arsalan0004/word-watch/V2/schematic and board/watchV2.brd

## EAGLE design V2/schematic and board/watchV2.brd (2021-01-21)

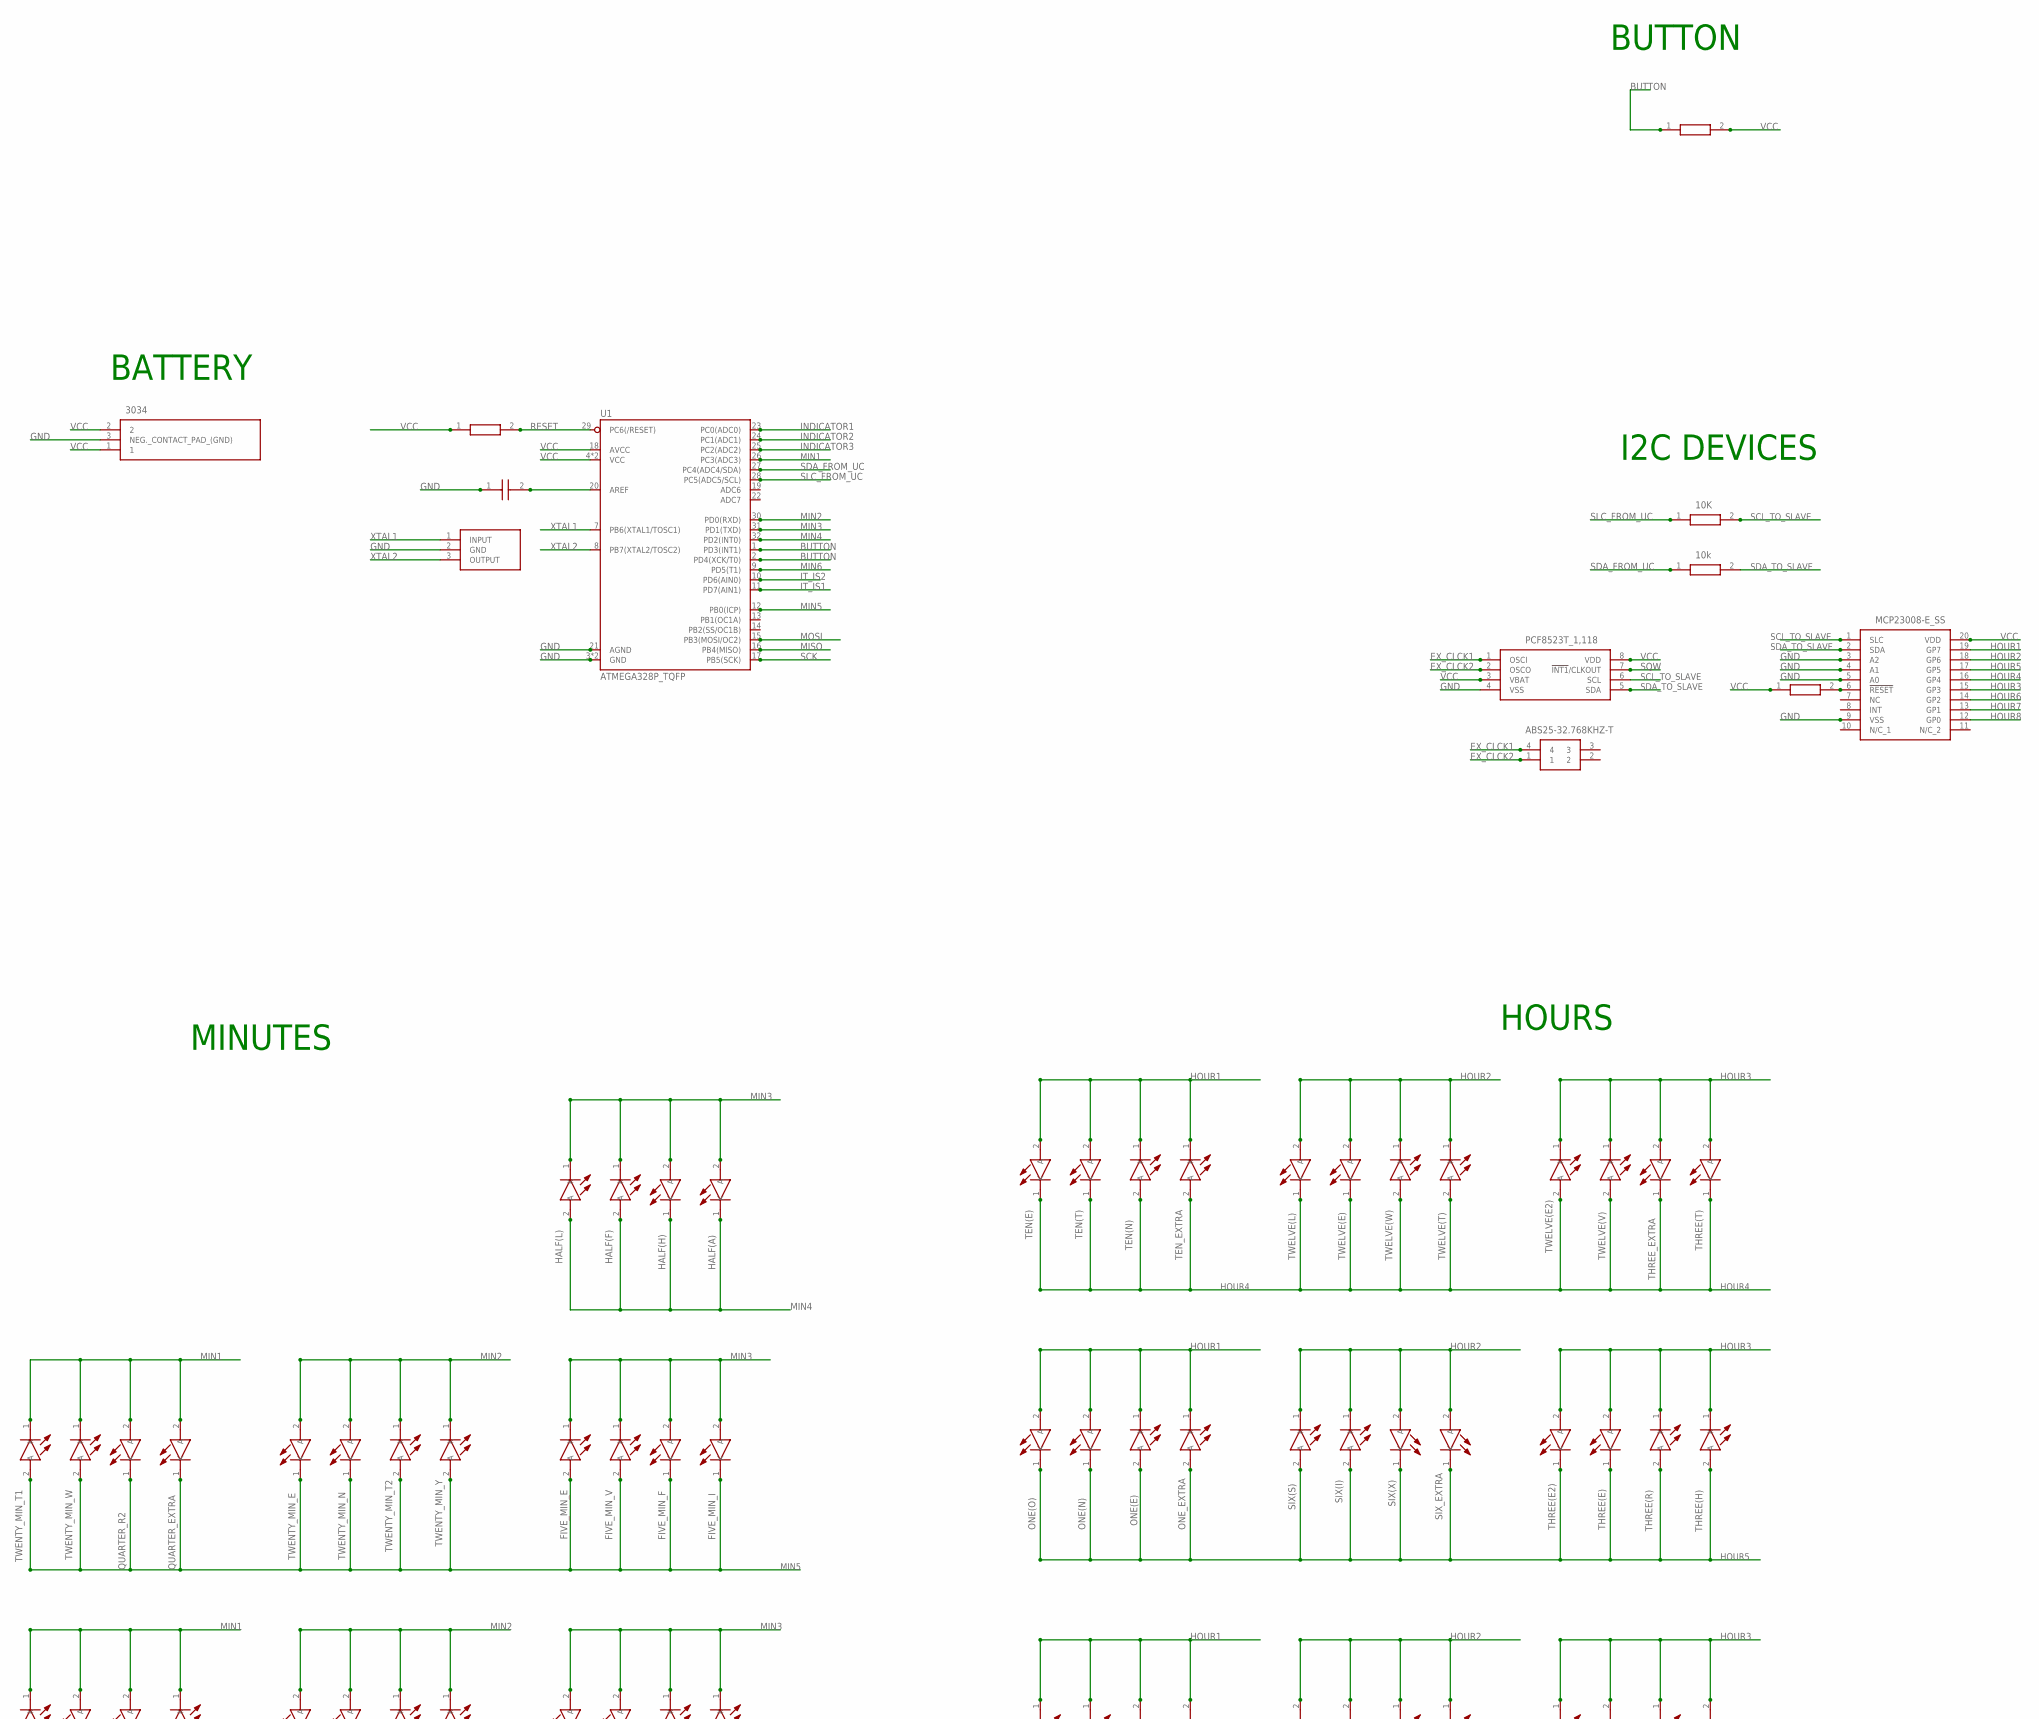
[picture p1: schematic watchV2.sch, part in row 1, column 1]

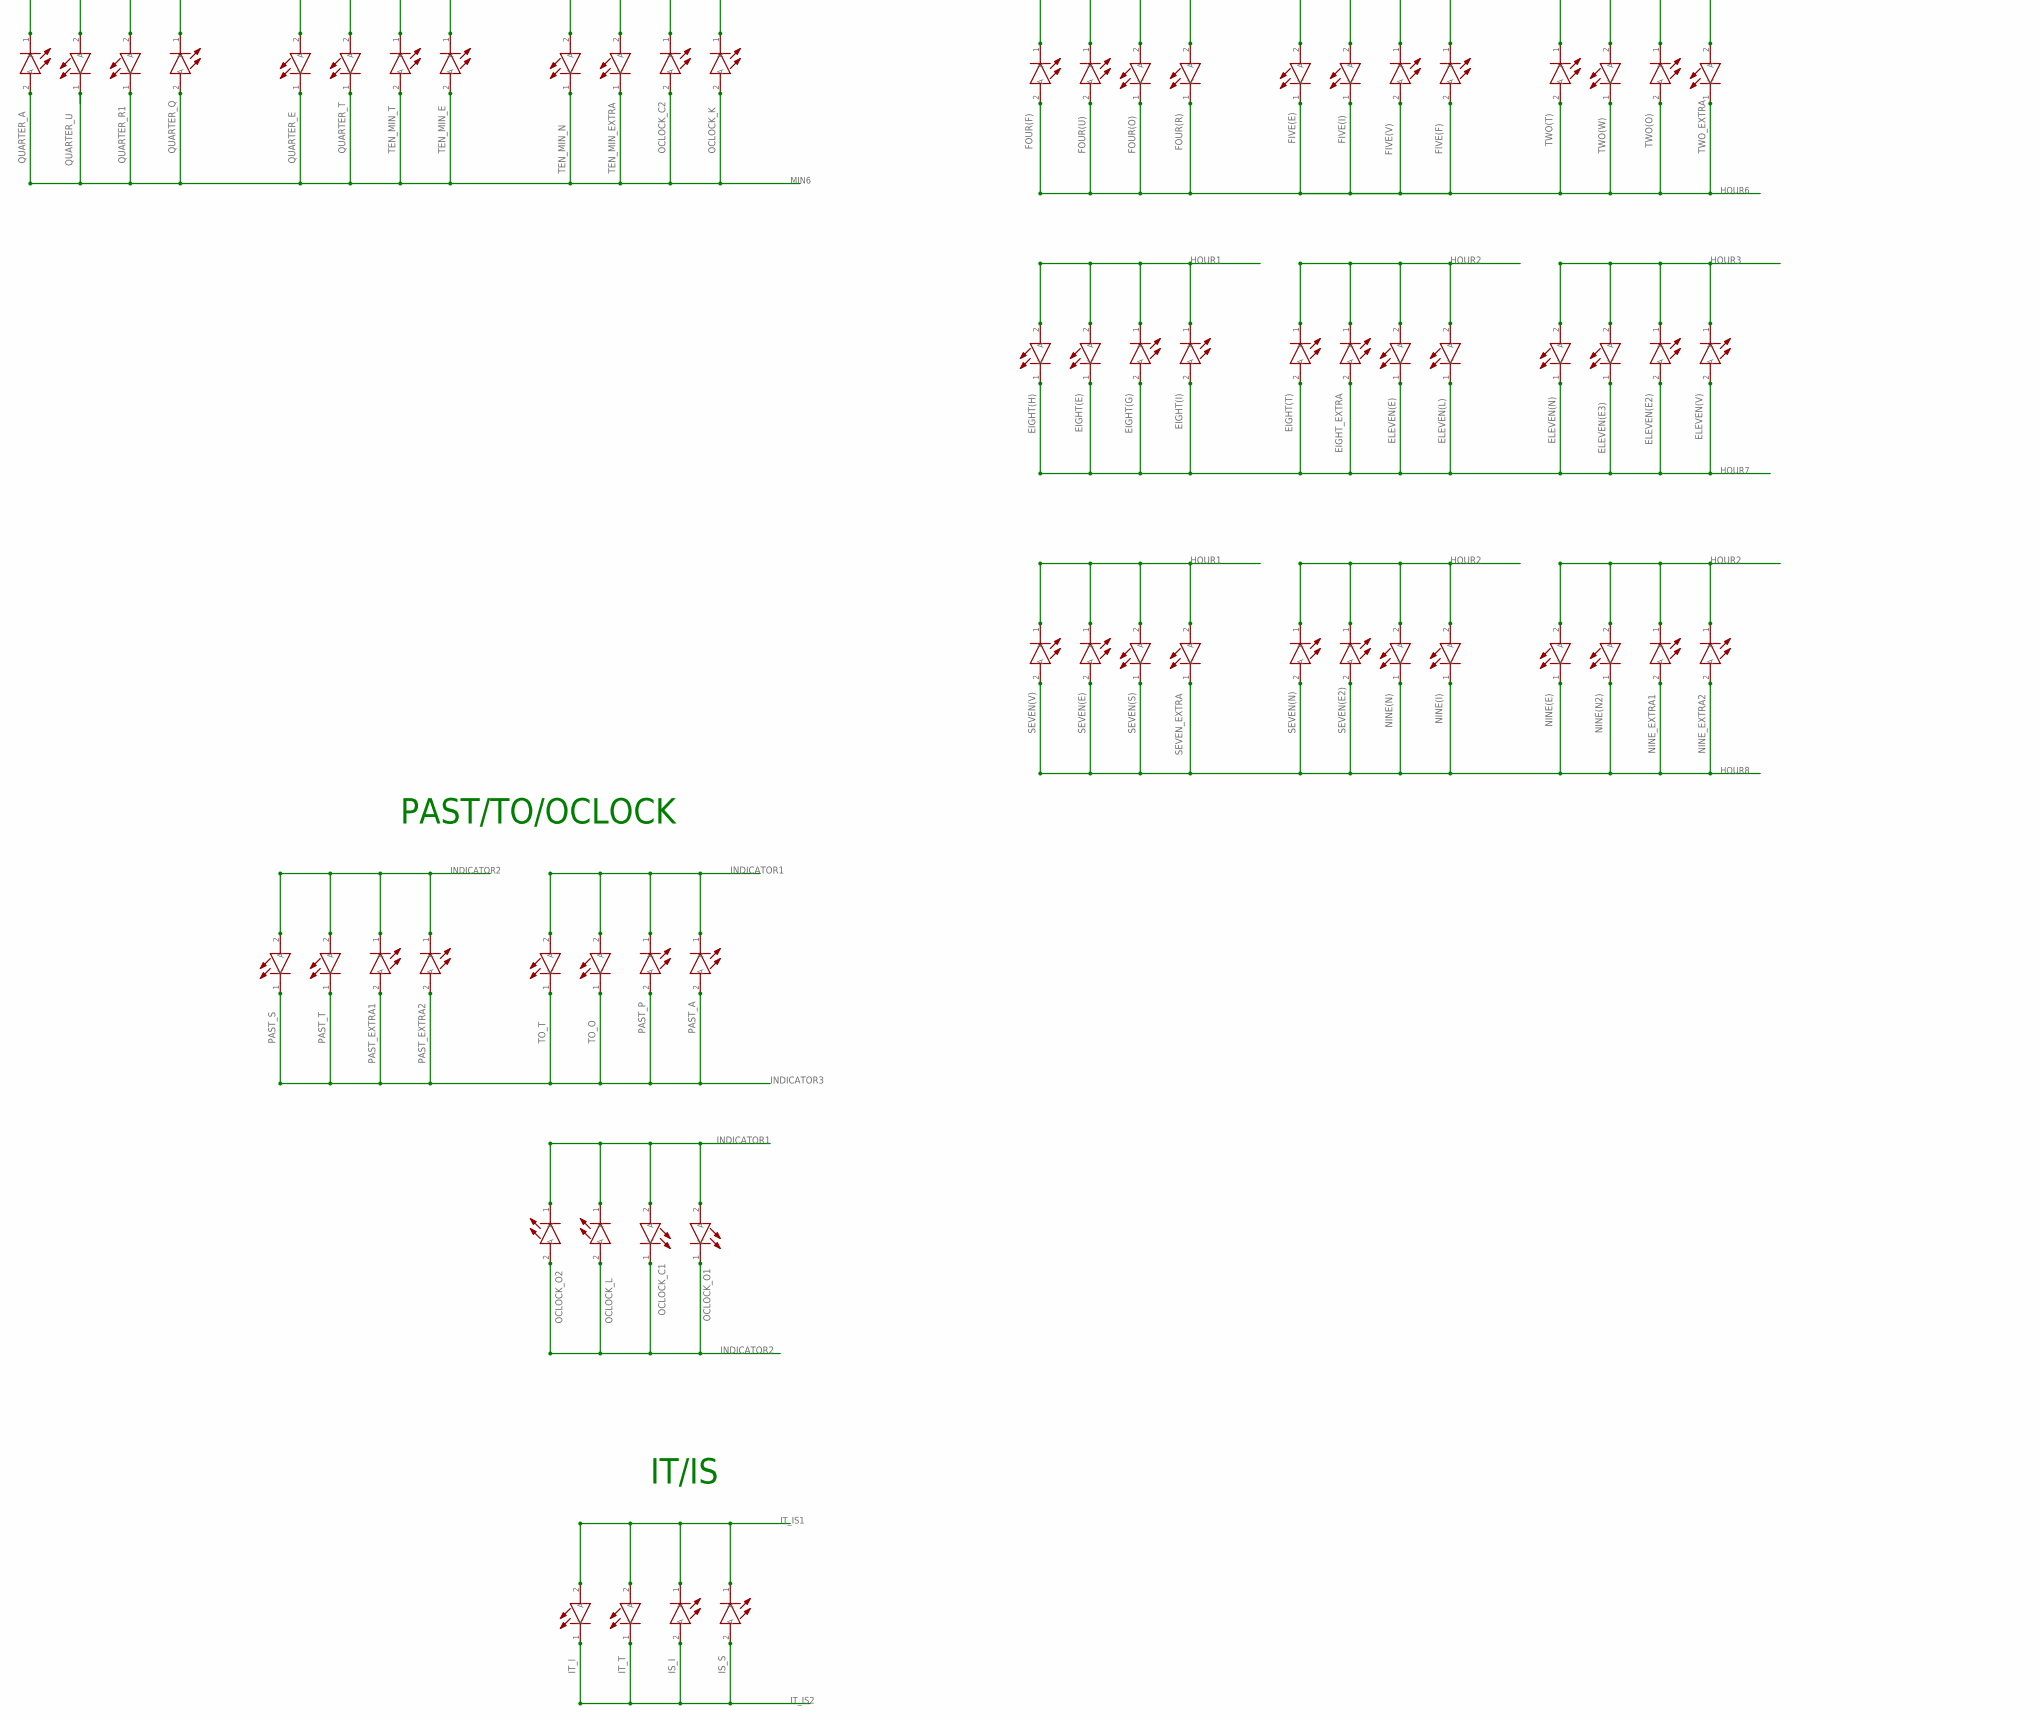
[picture p2: schematic watchV2.sch, part in row 2, column 1]

Parts:
10K: RC0402FR-0722RL; RESC1005X40N
C1: C0402C104Z4VAC; CAPC1005X55N
EIGHT(E): APHHS1005CGCK; LEDC1005X60N
EIGHT(G): APHHS1005CGCK; LEDC1005X60N
EIGHT(H): APHHS1005CGCK; LEDC1005X60N
EIGHT(I): APHHS1005CGCK; LEDC1005X60N
EIGHT(T): APHHS1005CGCK; LEDC1005X60N
EIGHT_EXTRA: APHHS1005CGCK; LEDC1005X60N
ELEVEN(E2), ELEVEN(E3): APHHS1005CGCK; LEDC1005X60N
ELEVEN(E): APHHS1005CGCK; LEDC1005X60N
ELEVEN(L): APHHS1005CGCK; LEDC1005X60N
ELEVEN(N): APHHS1005CGCK; LEDC1005X60N
ELEVEN(V): APHHS1005CGCK; LEDC1005X60N
FIVE(E): APHHS1005CGCK; LEDC1005X60N
FIVE(F): APHHS1005CGCK; LEDC1005X60N
FIVE(I): APHHS1005CGCK; LEDC1005X60N
FIVE(V): APHHS1005CGCK; LEDC1005X60N
FIVE_MIN_E: APHHS1005CGCK; LEDC1005X60N
FIVE_MIN_F: APHHS1005CGCK; LEDC1005X60N
FIVE_MIN_I: APHHS1005CGCK; LEDC1005X60N
FIVE_MIN_V: APHHS1005CGCK; LEDC1005X60N
FOUR(F): APHHS1005CGCK; LEDC1005X60N
FOUR(O): APHHS1005CGCK; LEDC1005X60N
FOUR(R): APHHS1005CGCK; LEDC1005X60N
FOUR(U): APHHS1005CGCK; LEDC1005X60N
HALF(A): APHHS1005CGCK; LEDC1005X60N
HALF(F): APHHS1005CGCK; LEDC1005X60N
HALF(H): APHHS1005CGCK; LEDC1005X60N
HALF(L): APHHS1005CGCK; LEDC1005X60N
IC1: MCP23008-E_SS; SOP65P780X200-20N
IC2: CSTNE16M0VH3C000R0
IC3: PCF8523T_1,118; SOIC127P600X175-8N
IS_I: APHHS1005CGCK; LEDC1005X60N
IS_S: APHHS1005CGCK; LEDC1005X60N
IT_I: APHHS1005CGCK; LEDC1005X60N
IT_T: APHHS1005CGCK; LEDC1005X60N
NINE(E): APHHS1005CGCK; LEDC1005X60N
NINE(I): APHHS1005CGCK; LEDC1005X60N
NINE(N2): APHHS1005CGCK; LEDC1005X60N
NINE(N): APHHS1005CGCK; LEDC1005X60N
NINE_EXTRA1, NINE_EXTRA2: APHHS1005CGCK; LEDC1005X60N
OCLOCK_C1, OCLOCK_C2: APHHS1005CGCK; LEDC1005X60N
OCLOCK_K: APHHS1005CGCK; LEDC1005X60N
OCLOCK_L: APHHS1005CGCK; LEDC1005X60N
OCLOCK_O1, OCLOCK_O2: APHHS1005CGCK; LEDC1005X60N
ONE(E): APHHS1005CGCK; LEDC1005X60N
ONE(N): APHHS1005CGCK; LEDC1005X60N
ONE(O): APHHS1005CGCK; LEDC1005X60N
ONE_EXTRA: APHHS1005CGCK; LEDC1005X60N
PAST_A: APHHS1005CGCK; LEDC1005X60N
PAST_EXTRA1: 48ohm; LEDC1005X60N
PAST_EXTRA2: APHHS1005CGCK; LEDC1005X60N
PAST_P: 48ohm; LEDC1005X60N
PAST_S: APHHS1005CGCK; LEDC1005X60N
PAST_T: APHHS1005CGCK; LEDC1005X60N
QUARTER_A: APHHS1005CGCK; LEDC1005X60N
QUARTER_E: APHHS1005CGCK; LEDC1005X60N
QUARTER_EXTRA: APHHS1005CGCK; LEDC1005X60N
QUARTER_Q: APHHS1005CGCK; LEDC1005X60N
QUARTER_R1, QUARTER_R2: APHHS1005CGCK; LEDC1005X60N
QUARTER_T: APHHS1005CGCK; LEDC1005X60N
QUARTER_U: APHHS1005CGCK; LEDC1005X60N
RED1, RED2, RED5: RC0402FR-0722RL; RESC1005X40N
RED7: 10k; RESC1005X40N
SEVEN(E2): APHHS1005CGCK; LEDC1005X60N
SEVEN(E): APHHS1005CGCK; LEDC1005X60N
SEVEN(N): APHHS1005CGCK; LEDC1005X60N
SEVEN(S): APHHS1005CGCK; LEDC1005X60N
SEVEN(V): APHHS1005CGCK; LEDC1005X60N
SEVEN_EXTRA: APHHS1005CGCK; LEDC1005X60N
SIX(I): APHHS1005CGCK; LEDC1005X60N
SIX(S): APHHS1005CGCK; LEDC1005X60N
SIX(X): APHHS1005CGCK; LEDC1005X60N
SIX_EXTRA: APHHS1005CGCK; LEDC1005X60N
TEN(E): APHHS1005CGCK; LEDC1005X60N
TEN(N): APHHS1005CGCK; LEDC1005X60N
TEN(T): APHHS1005CGCK; LEDC1005X60N
TEN_EXTRA: APHHS1005CGCK; LEDC1005X60N
TEN_MIN_E: APHHS1005CGCK; LEDC1005X60N
TEN_MIN_EXTRA: APHHS1005CGCK; LEDC1005X60N
TEN_MIN_N: APHHS1005CGCK; LEDC1005X60N
TEN_MIN_T: APHHS1005CGCK; LEDC1005X60N
THREE(E2): APHHS1005CGCK; LEDC1005X60N
THREE(E): APHHS1005CGCK; LEDC1005X60N
THREE(H): APHHS1005CGCK; LEDC1005X60N
THREE(R): APHHS1005CGCK; LEDC1005X60N
THREE(T): APHHS1005CGCK; LEDC1005X60N
THREE_EXTRA: APHHS1005CGCK; LEDC1005X60N
TO_O: APHHS1005CGCK; LEDC1005X60N
TO_T: APHHS1005CGCK; LEDC1005X60N
TWELVE(E2): APHHS1005CGCK; LEDC1005X60N
TWELVE(E): APHHS1005CGCK; LEDC1005X60N
TWELVE(L): APHHS1005CGCK; LEDC1005X60N
TWELVE(T): APHHS1005CGCK; LEDC1005X60N
TWELVE(V): APHHS1005CGCK; LEDC1005X60N
TWELVE(W): APHHS1005CGCK; LEDC1005X60N
TWENTY_MIN_E: APHHS1005CGCK; LEDC1005X60N
TWENTY_MIN_N: APHHS1005CGCK; LEDC1005X60N
TWENTY_MIN_T1, TWENTY_MIN_T2: APHHS1005CGCK; LEDC1005X60N
TWENTY_MIN_W: APHHS1005CGCK; LEDC1005X60N
TWENTY_MIN_Y: APHHS1005CGCK; LEDC1005X60N
TWO(O): APHHS1005CGCK; LEDC1005X60N
TWO(T): APHHS1005CGCK; LEDC1005X60N
TWO(W): APHHS1005CGCK; LEDC1005X60N
TWO_EXTRA: APHHS1005CGCK; LEDC1005X60N
U1: ATMEGA328P_TQFP; TQFP32-08
U2: 3034
Y1: ABS25-32.768KHZ-T; ABS2532768KHZT

Connections:
BUTTON: RED1.1, U1.1 (PD3(INT1)), U1.2 (PD4(XCK/T0))
EX_CLCK1: IC3.1 (OSCI), Y1.4
EX_CLCK2: IC3.2 (OSCO), Y1.1
GND: C1.1, IC1.3 (A2), IC1.4 (A1), IC1.5 (A0), IC1.9 (VSS), IC2.2 (GND), IC3.4 (VSS), U1.3 (GND), U1.5 (GND), U1.21 (AGND), U2.3 (NEG._CONTACT_PAD_(GND))
HOUR1: EIGHT(E).2 (A), EIGHT(G).1 (K), EIGHT(H).2 (A), EIGHT(I).1 (K), FOUR(F).1 (K), FOUR(O).2 (A), FOUR(R).2 (A), FOUR(U).1 (K), IC1.19 (GP7), ONE(E).1 (K), ONE(N).2 (A), ONE(O).2 (A), ONE_EXTRA.1 (K), SEVEN(E).1 (K), SEVEN(S).2 (A), SEVEN(V).1 (K), SEVEN_EXTRA.2 (A), TEN(E).2 (A), TEN(N).1 (K), TEN(T).2 (A), TEN_EXTRA.1 (K)
HOUR2: EIGHT(T).1 (K), EIGHT_EXTRA.1 (K), ELEVEN(E).2 (A), ELEVEN(L).2 (A), FIVE(E).2 (A), FIVE(F).1 (K), FIVE(I).2 (A), FIVE(V).1 (K), IC1.18 (GP6), NINE(E).2 (A), NINE(I).2 (A), NINE(N2).2 (A), NINE(N).2 (A), NINE_EXTRA1.1 (K), NINE_EXTRA2.1 (K), SEVEN(E2).1 (K), SEVEN(N).1 (K), SIX(I).1 (K), SIX(S).1 (K), SIX(X).2 (A), SIX_EXTRA.2 (A), TWELVE(E).2 (A), TWELVE(L).2 (A), TWELVE(T).1 (K), TWELVE(W).1 (K)
HOUR3: ELEVEN(E2).1 (K), ELEVEN(E3).2 (A), ELEVEN(N).2 (A), ELEVEN(V).1 (K), IC1.15 (GP3), THREE(E2).2 (A), THREE(E).2 (A), THREE(H).1 (K), THREE(R).1 (K), THREE(T).2 (A), THREE_EXTRA.2 (A), TWELVE(E2).1 (K), TWELVE(V).1 (K), TWO(O).1 (K), TWO(T).1 (K), TWO(W).2 (A), TWO_EXTRA.2 (A)
HOUR4: IC1.16 (GP4), TEN(E).1 (K), TEN(N).2 (A), TEN(T).1 (K), TEN_EXTRA.2 (A), THREE(T).1 (K), THREE_EXTRA.1 (K), TWELVE(E2).2 (A), TWELVE(E).1 (K), TWELVE(L).1 (K), TWELVE(T).2 (A), TWELVE(V).2 (A), TWELVE(W).2 (A)
HOUR5: IC1.17 (GP5), ONE(E).2 (A), ONE(N).1 (K), ONE(O).1 (K), ONE_EXTRA.2 (A), SIX(I).2 (A), SIX(S).2 (A), SIX(X).1 (K), SIX_EXTRA.1 (K), THREE(E2).1 (K), THREE(E).1 (K), THREE(H).2 (A), THREE(R).2 (A)
HOUR6: FIVE(E).1 (K), FIVE(F).2 (A), FIVE(I).1 (K), FIVE(V).2 (A), FOUR(F).2 (A), FOUR(O).1 (K), FOUR(R).1 (K), FOUR(U).2 (A), IC1.14 (GP2), TWO(O).2 (A), TWO(T).2 (A), TWO(W).1 (K), TWO_EXTRA.1 (K)
HOUR7: EIGHT(E).1 (K), EIGHT(G).2 (A), EIGHT(H).1 (K), EIGHT(I).2 (A), EIGHT(T).2 (A), EIGHT_EXTRA.2 (A), ELEVEN(E2).2 (A), ELEVEN(E3).1 (K), ELEVEN(E).1 (K), ELEVEN(L).1 (K), ELEVEN(N).1 (K), ELEVEN(V).2 (A), IC1.13 (GP1)
HOUR8: IC1.12 (GP0), NINE(E).1 (K), NINE(I).1 (K), NINE(N2).1 (K), NINE(N).1 (K), NINE_EXTRA1.2 (A), NINE_EXTRA2.2 (A), SEVEN(E2).2 (A), SEVEN(E).2 (A), SEVEN(N).2 (A), SEVEN(S).1 (K), SEVEN(V).2 (A), SEVEN_EXTRA.1 (K)
INDICATOR1: OCLOCK_C1.2 (A), OCLOCK_L.1 (K), OCLOCK_O1.2 (A), OCLOCK_O2.1 (K), PAST_A.1 (K), PAST_P.1 (K), TO_O.2 (A), TO_T.2 (A), U1.23 (PC0(ADC0))
INDICATOR2: OCLOCK_C1.1 (K), OCLOCK_L.2 (A), OCLOCK_O1.1 (K), OCLOCK_O2.2 (A), PAST_EXTRA1.1 (K), PAST_EXTRA2.1 (K), PAST_S.2 (A), PAST_T.2 (A), U1.24 (PC1(ADC1))
INDICATOR3: PAST_A.2 (A), PAST_EXTRA1.2 (A), PAST_EXTRA2.2 (A), PAST_P.2 (A), PAST_S.1 (K), PAST_T.1 (K), TO_O.1 (K), TO_T.1 (K), U1.25 (PC2(ADC2))
IT_IS1: IS_I.1 (K), IS_S.1 (K), IT_I.2 (A), IT_T.2 (A), U1.11 (PD7(AIN1))
IT_IS2: IS_I.2 (A), IS_S.2 (A), IT_I.1 (K), IT_T.1 (K), U1.10 (PD6(AIN0))
MIN1: QUARTER_A.1 (K), QUARTER_EXTRA.2 (A), QUARTER_Q.1 (K), QUARTER_R1.2 (A), QUARTER_R2.2 (A), QUARTER_U.2 (A), TWENTY_MIN_T1.1 (K), TWENTY_MIN_W.1 (K), U1.26 (PC3(ADC3))
MIN2: QUARTER_E.2 (A), QUARTER_T.2 (A), TEN_MIN_E.1 (K), TEN_MIN_T.1 (K), TWENTY_MIN_E.2 (A), TWENTY_MIN_N.2 (A), TWENTY_MIN_T2.1 (K), TWENTY_MIN_Y.1 (K), U1.30 (PD0(RXD))
MIN3: FIVE_MIN_E.1 (K), FIVE_MIN_F.2 (A), FIVE_MIN_I.2 (A), FIVE_MIN_V.1 (K), HALF(A).2 (A), HALF(F).1 (K), HALF(H).2 (A), HALF(L).1 (K), OCLOCK_C2.1 (K), OCLOCK_K.1 (K), TEN_MIN_EXTRA.2 (A), TEN_MIN_N.2 (A), U1.31 (PD1(TXD))
MIN4: HALF(A).1 (K), HALF(F).2 (A), HALF(H).1 (K), HALF(L).2 (A), U1.32 (PD2(INT0))
MIN5: FIVE_MIN_E.2 (A), FIVE_MIN_F.1 (K), FIVE_MIN_I.1 (K), FIVE_MIN_V.2 (A), QUARTER_EXTRA.1 (K), QUARTER_R2.1 (K), TWENTY_MIN_E.1 (K), TWENTY_MIN_N.1 (K), TWENTY_MIN_T1.2 (A), TWENTY_MIN_T2.2 (A), TWENTY_MIN_W.2 (A), TWENTY_MIN_Y.2 (A), U1.12 (PB0(ICP))
MIN6: OCLOCK_C2.2 (A), OCLOCK_K.2 (A), QUARTER_A.2 (A), QUARTER_E.1 (K), QUARTER_Q.2 (A), QUARTER_R1.1 (K), QUARTER_T.1 (K), QUARTER_U.1 (K), TEN_MIN_E.2 (A), TEN_MIN_EXTRA.1 (K), TEN_MIN_N.1 (K), TEN_MIN_T.2 (A), U1.9 (PD5(T1))
MISO: U1.16 (PB4(MISO))
MOSI: U1.15 (PB3(MOSI/OC2))
unnamed: IC1.6 (!RESET), RED2.2
unnamed: C1.2, U1.20 (AREF)
RESET: RED5.2, U1.29 (PC6(/RESET))
SCK: U1.17 (PB5(SCK))
SCL_TO_SLAVE: 10K.2, IC1.1 (SLC), IC3.6 (SCL)
SDA_FROM_UC: RED7.1, U1.27 (PC4(ADC4/SDA))
SDA_TO_SLAVE: IC1.2 (SDA), IC3.5 (SDA), RED7.2
SLC_FROM_UC: 10K.1, U1.28 (PC5(ADC5/SCL))
SQW: IC3.7 (!INT1!/CLKOUT)
VCC: IC1.20 (VDD), IC3.3 (VBAT), IC3.8 (VDD), RED1.2, RED2.1, RED5.1, U1.4 (VCC), U1.6 (VCC), U1.18 (AVCC), U2.1, U2.2
XTAL1: IC2.1 (INPUT), U1.7 (PB6(XTAL1/TOSC1))
XTAL2: IC2.3 (OUTPUT), U1.8 (PB7(XTAL2/TOSC2))

Notes on the sheet:
HOURS
MINUTES
IT/IS
I2C DEVICES
BUTTON
BATTERY
PAST/TO/OCLOCK

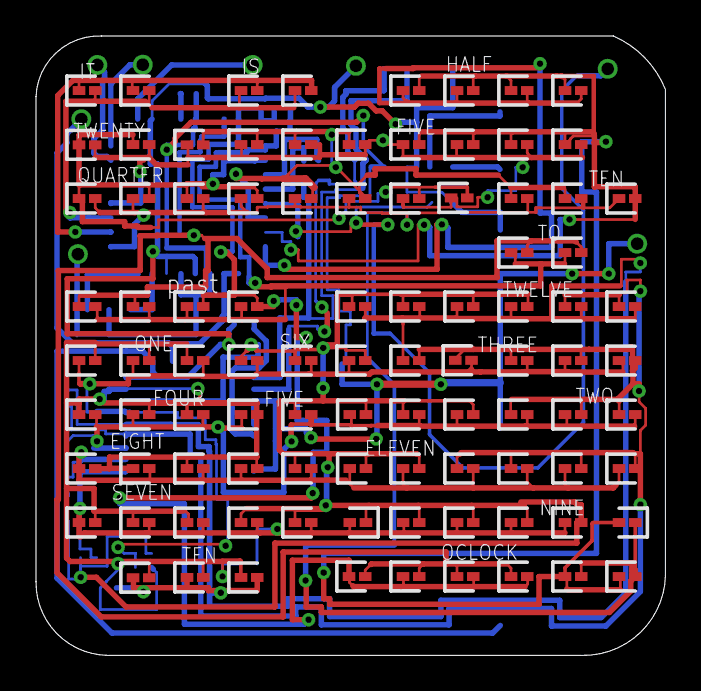
[picture p3: board watchV2.brd from above]

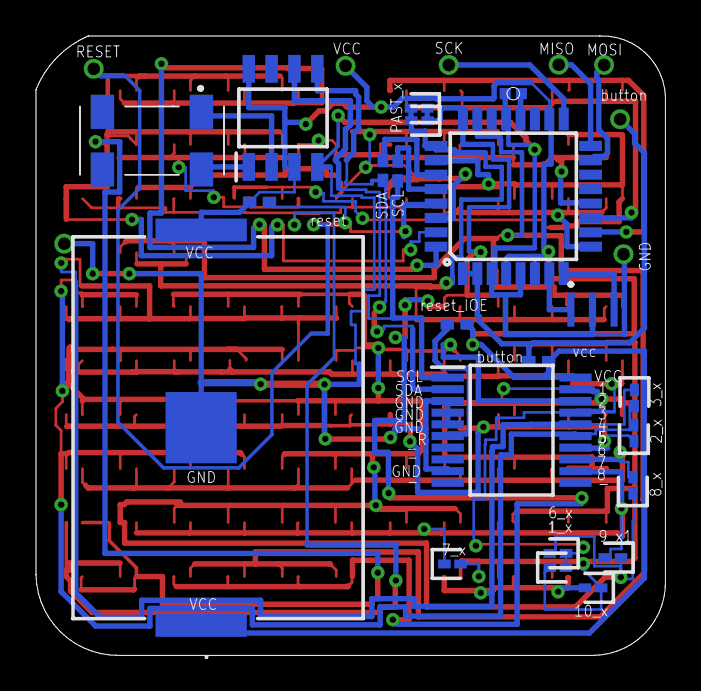
[picture p4: board watchV2.brd from below]

Board: 2 copper layers, 35.0 x 34.4 mm, 116 parts (22 on the bottom side), 33 nets.
