arsalan0004/word-watch/(commit log)

2020-02-19 Update CurrentSketch.ino
    added some button functionality
2020-02-21 Update CurrentSketch.ino
    1/2 of code for changing time is complete
2020-02-23 Update CurrentSketch.ino
    set up pointer system for managing time changes.
2021-01-06 top layer is immaculate
    wired an immaculate top-layer on the watch board
    [Watch V2.brd, Watch V2.sch, immaculate top layer.brd, immaculate top layer.sch, watch circuit board.brd, watch schematic.sch]
2021-01-19 Moved old version of the watch into the folder 'V1' and started working on the new watch code, which is being developed inside folder 'V2'
    [Watch V2.brd, Watch V2.sch, immaculate top layer.brd, immaculate top layer.sch]
2021-01-20 fixed syntax issues so the document would compile
    [Hour_Functions.ino]
2021-01-21 addeed all 'hour functions' and included the new schematic and board from Eagle
    [watchV2.brd, watchV2.sch]
